cheeragpatel/copilot-lamp/copilot-lamp.step

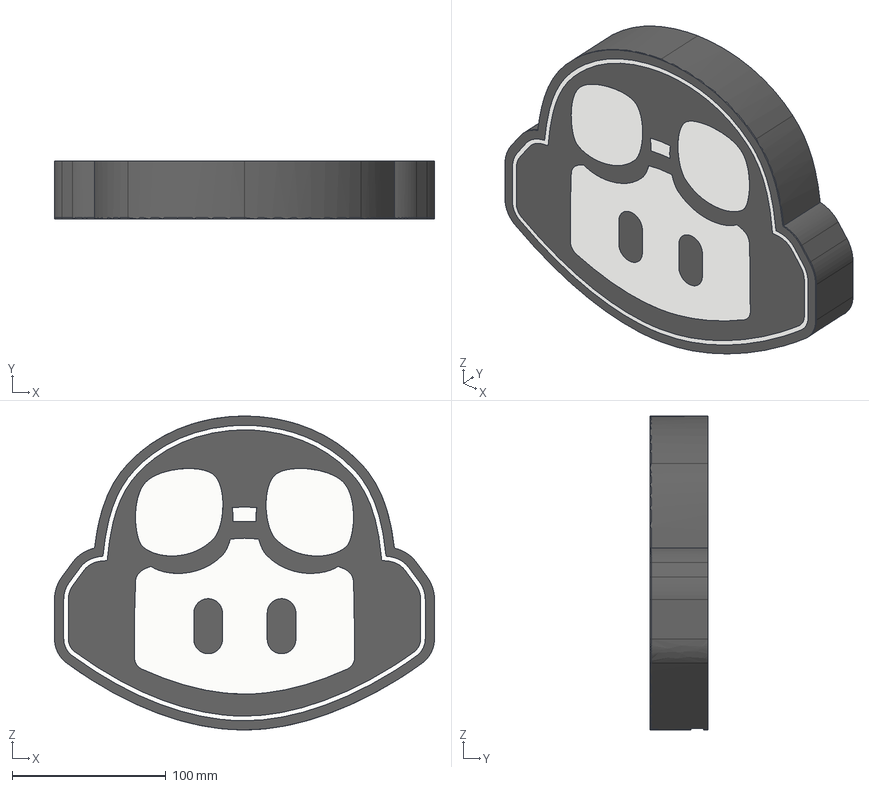
[picture p2: CAD file, 2024-03-25]
copilot-lamp.step
246.9 x 38.0 x 204.0 mm
Back
Black
White
Reflector
