cheeragpatel/copilot-lamp/(list of files, cad)

Other CAD files:
copilot-lamp.3mf
copilot-lamp.f3d
