cheeragpatel/copilot-lamp/(commit log)

2024-03-11 Initial Commit
    Added base f3d, step and 3mf files.
    [copilot-lamp.3mf, copilot-lamp.f3d, copilot-lamp.step]
2024-03-25 Latest version with inset reflector
    [copilot-lamp.3mf, copilot-lamp.f3d, copilot-lamp.step]
2024-04-02 Added assembly instructions
2024-04-02 Added mounting step
